xil-se/xildebug_hw/schematics.pdf

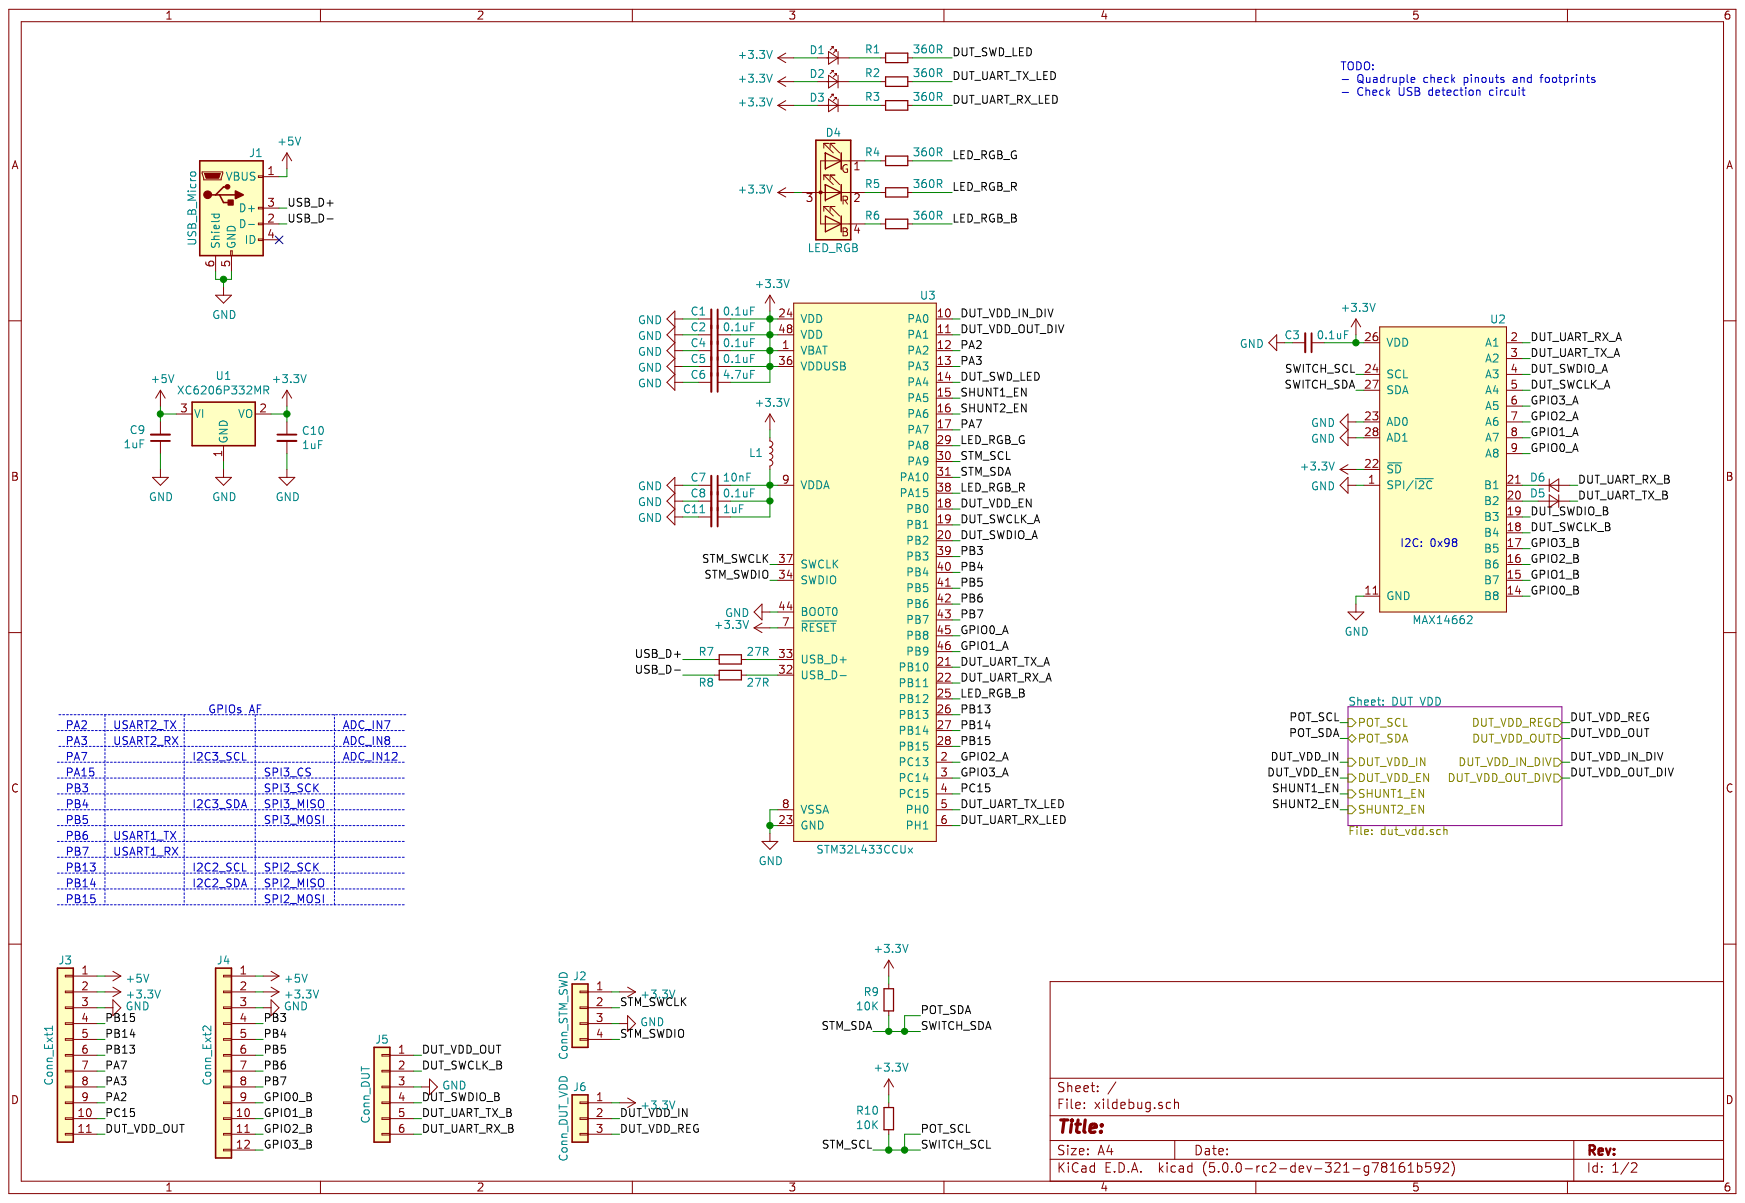
[picture p1: page 1]

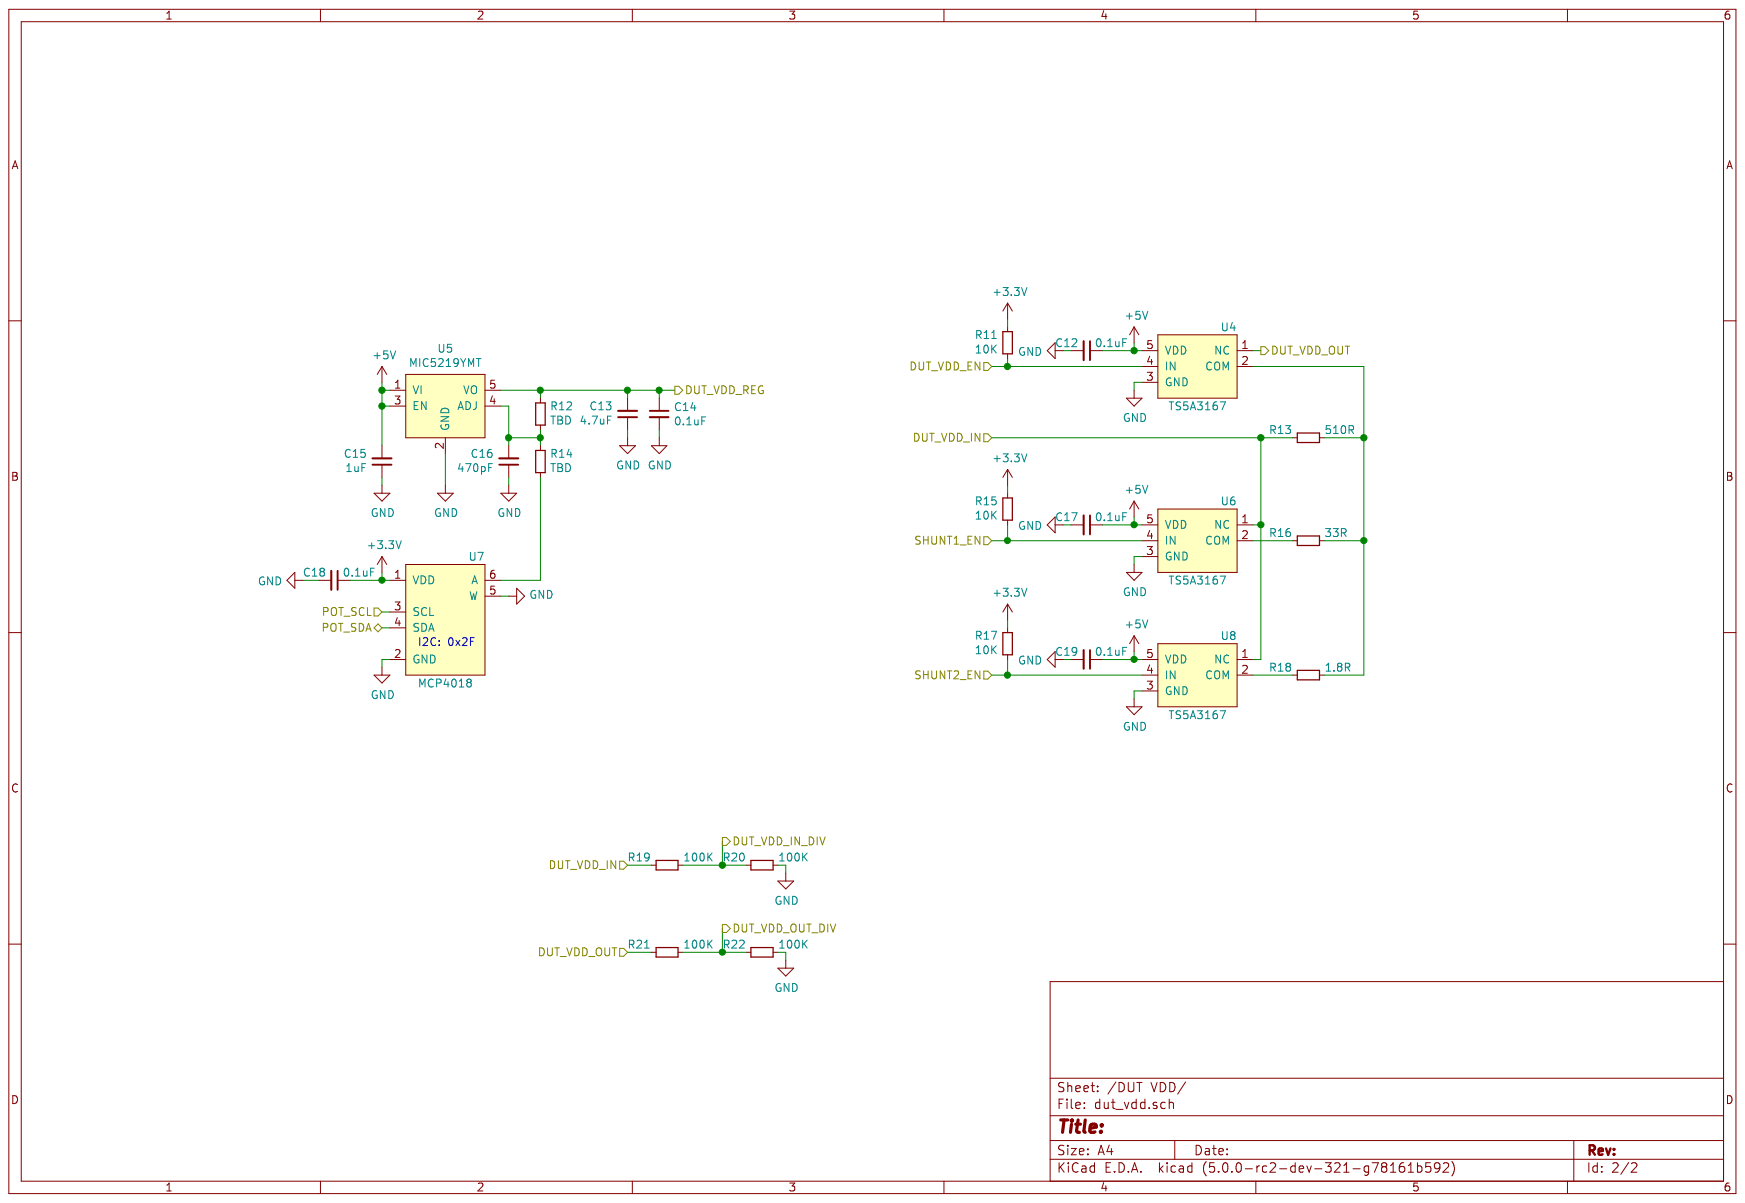
[picture p2: page 2]
