xil-se/xildebug_hw/xildebug.kicad_pcb

## KiCad design xildebug.kicad_pcb (2018-04-21)

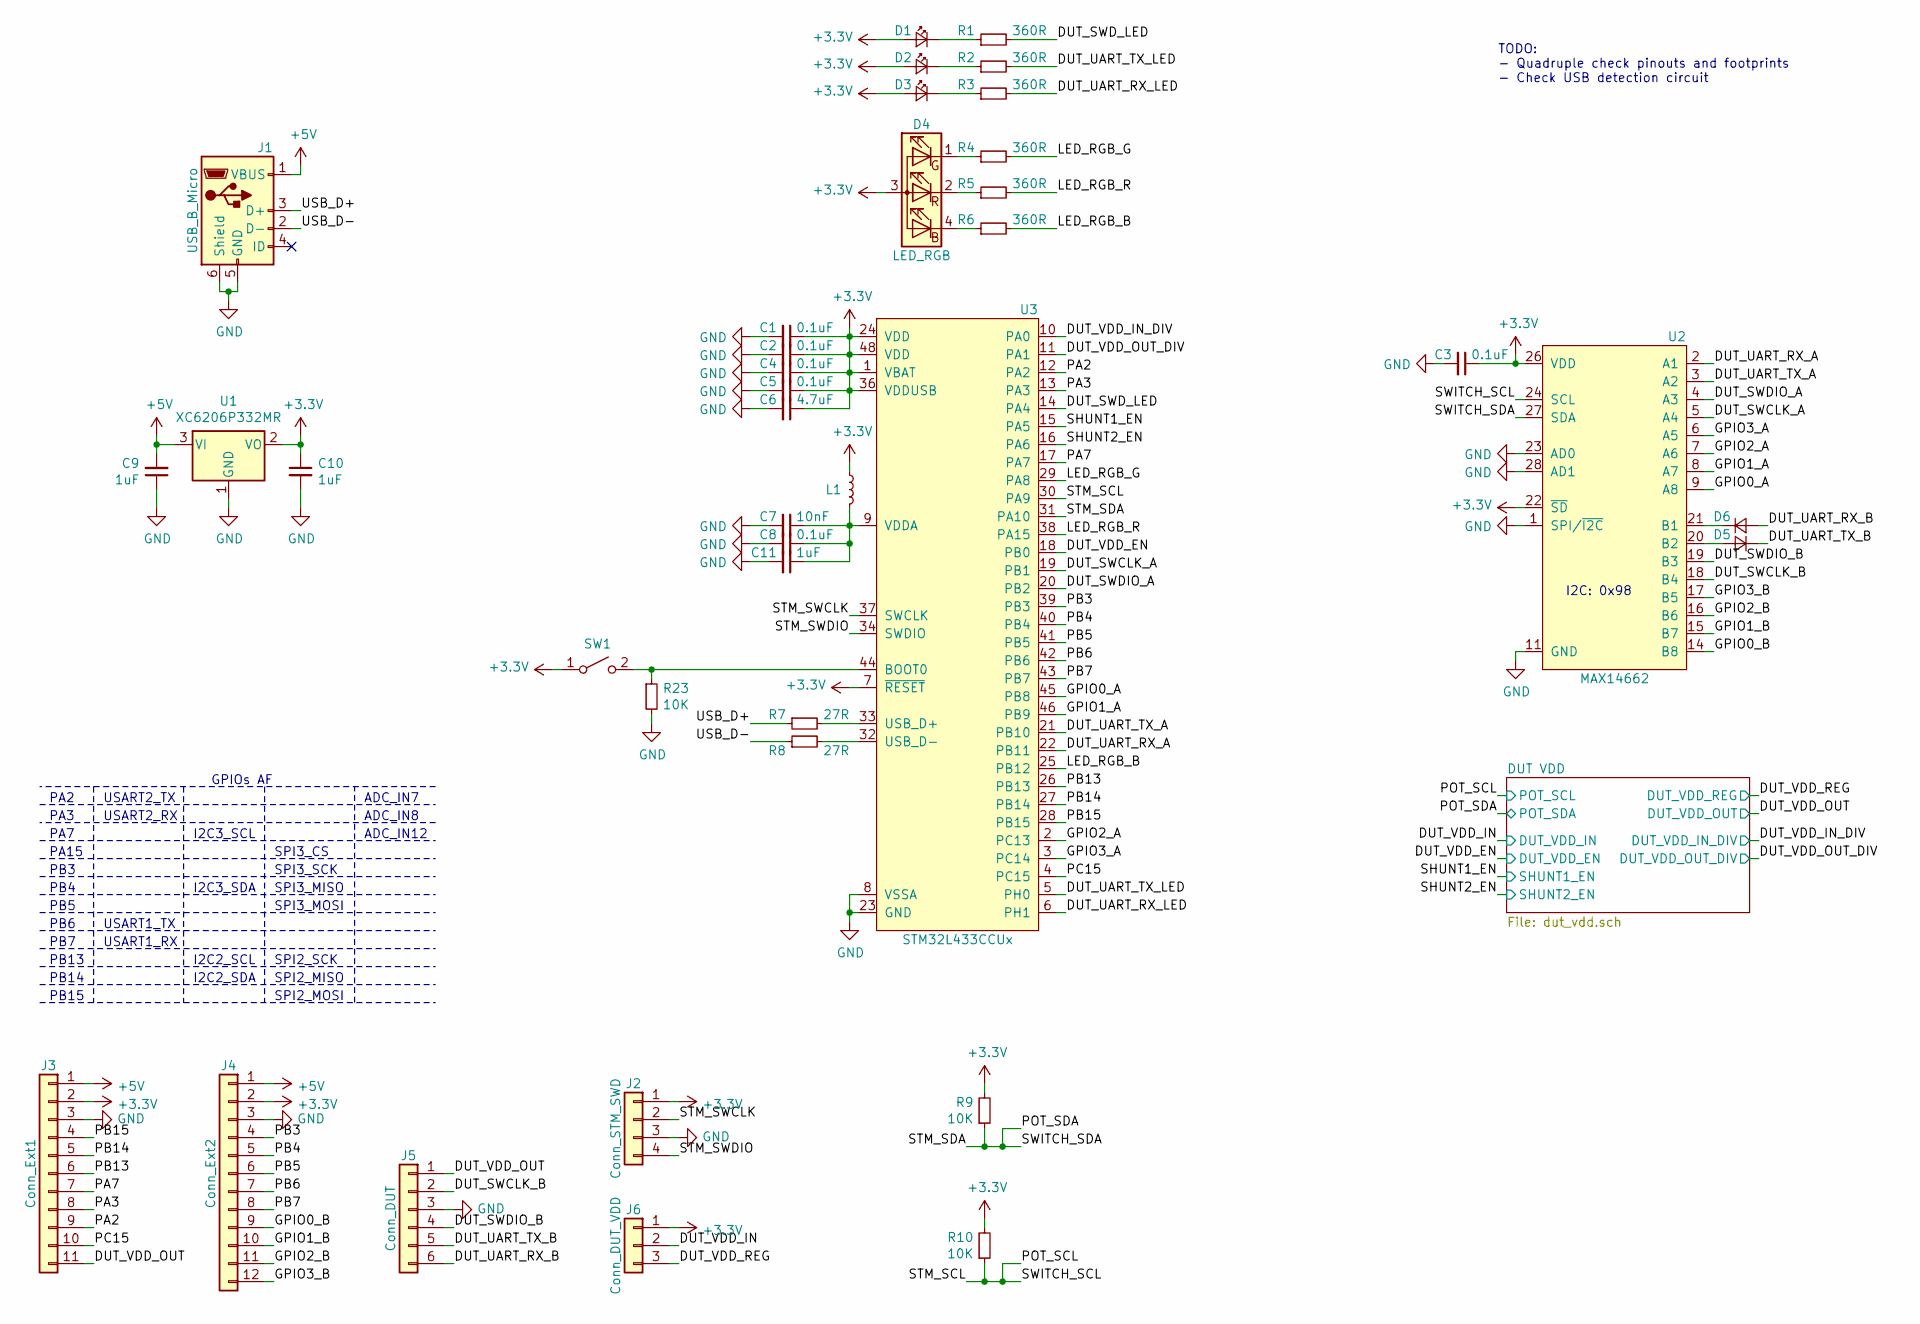
[picture p3: schematic xildebug.sch]

Parts:
C1, C2, C3, C4, C5, C8: 0.1uF; C_0603_1608Metric
C6: 4.7uF; C_0603_1608Metric
C7: 10nF; C_0603_1608Metric
C9, C10, C11: 1uF; C_0603_1608Metric
D1, D2, D3: DUT_UART_TX_LED; LED_0603_1608Metric
D4: LED_RGB; LED_RGB_0606_1616Metric
D5: D_TX; D_SOD-323_HandSoldering
D6: D_RX; D_SOD-323_HandSoldering
J1: USB_B_Micro; USB_Micro-B_Molex-105017-0001
J2: Conn_STM_SWD; PinHeader_1x04_P2.54mm_Vertical
J3: Conn_Ext1; PinHeader_1x11_P2.54mm_Vertical
J4: Conn_Ext2; PinHeader_1x12_P2.54mm_Vertical
J5: Conn_DUT; PinHeader_1x06_P2.54mm_Vertical
J6: Conn_DUT_VDD; PinHeader_1x03_P2.54mm_Horizontal
L1: FB; L_0603_1608Metric
R1, R2, R3, R4, R5, R6: 360R; R_0603_1608Metric
R7, R8: 27R; R_0603_1608Metric
R9, R10, R23: 10K; R_0603_1608Metric
SW1: BOOT0; SW_SPST_B3U-1000P
U1: XC6206P332MR; SOT-23
U2: MAX14662; QFN-28-1EP_4x4mm_P0.4mm_EP2.4x2.4mm
U3: STM32L433CCUx; UFQFPN-48-1EP_7x7mm_P0.5mm_EP5.15x5.15mm

Connections:
+3V3: C1.1, C2.1, C3.1, C4.1, C5.1, C6.1, C10.1, D1.2 (A), D2.2 (A), D3.2 (A), D4.3 (A), J2.1, J3.2, J4.2, J6.1, L1.2, R9.2, R10.2, SW1.1 (A), U1.2 (VO), U2.22 (~SD~), U2.26 (VDD), U3.1 (VBAT), U3.7 (~RESET~), U3.24 (VDD), U3.36 (VDDUSB), U3.48 (VDD); also elsewhere on the board
+5V: C9.2, J1.1 (VBUS), J3.1, J4.1, U1.3 (VI); also elsewhere on the board
/DUT_SWCLK_A: U2.5 (A4), U3.19 (PB1)
/DUT_SWCLK_B: J5.2, U2.18 (B4)
/DUT_SWDIO_A: U2.4 (A3), U3.20 (PB2)
/DUT_SWDIO_B: J5.4, U2.19 (B3)
/DUT_SWD_LED: R1.2, U3.14 (PA4)
/DUT_UART_RX_A: U2.2 (A1), U3.22 (PB11)
/DUT_UART_RX_B: D6.2 (A), J5.6
/DUT_UART_RX_LED: R3.2, U3.6 (PH1)
/DUT_UART_TX_A: U2.3 (A2), U3.21 (PB10)
/DUT_UART_TX_B: D5.1 (K), J5.5
/DUT_UART_TX_LED: R2.2, U3.5 (PH0)
/DUT_VDD_EN: U3.18 (PB0); also elsewhere on the board
/DUT_VDD_IN: J6.2; also elsewhere on the board
/DUT_VDD_IN_DIV: U3.10 (PA0); also elsewhere on the board
/DUT_VDD_OUT: J3.11, J5.1; also elsewhere on the board
/DUT_VDD_OUT_DIV: U3.11 (PA1); also elsewhere on the board
/DUT_VDD_REG: J6.3; also elsewhere on the board
/GPIO0_A: U2.9 (A8), U3.45 (PB8)
/GPIO0_B: J4.9, U2.14 (B8)
/GPIO1_A: U2.8 (A7), U3.46 (PB9)
/GPIO1_B: J4.10, U2.15 (B7)
/GPIO2_A: U2.7 (A6), U3.2 (PC13)
/GPIO2_B: J4.11, U2.16 (B6)
/GPIO3_A: U2.6 (A5), U3.3 (PC14)
/GPIO3_B: J4.12, U2.17 (B5)
/LED_RGB_B: R6.2, U3.25 (PB12)
/LED_RGB_G: R4.2, U3.29 (PA8)
/LED_RGB_R: R5.2, U3.38 (PA15)
/PA2: J3.9, U3.12 (PA2)
/PA3: J3.8, U3.13 (PA3)
/PA7: J3.7, U3.17 (PA7)
/PB3: J4.4, U3.39 (PB3)
/PB4: J4.5, U3.40 (PB4)
/PB5: J4.6, U3.41 (PB5)
/PB6: J4.7, U3.42 (PB6)
/PB7: J4.8, U3.43 (PB7)
/PB13: J3.6, U3.26 (PB13)
/PB14: J3.5, U3.27 (PB14)
/PB15: J3.4, U3.28 (PB15)
/PC15: J3.10, U3.4 (PC15)
/POT_SCL: R10.1, U2.24 (SCL), U3.30 (PA9); also elsewhere on the board
/POT_SDA: R9.1, U2.27 (SDA), U3.31 (PA10); also elsewhere on the board
/SHUNT1_EN: U3.15 (PA5); also elsewhere on the board
/SHUNT2_EN: U3.16 (PA6); also elsewhere on the board
/STM_SWCLK: J2.2, U3.37 (SWCLK)
/STM_SWDIO: J2.4, U3.34 (SWDIO)
/USB_D+: J1.3 (D+), R7.1
/USB_D-: J1.2 (D-), R8.1
GND: C1.2, C2.2, C3.2, C4.2, C5.2, C6.2, C7.2, C8.2, C9.1, C10.2, C11.2, J1.5 (GND), J1.6 (Shield), J2.3, J3.3, J4.3, J5.3, R23.2, U1.1 (GND), U2.1 (SPI/~I2C~), U2.11 (GND), U2.23 (AD0), U2.25 (GND), U2.28 (AD1), U2.29 (GND), U3.8 (VSSA), U3.23 (GND), U3.35 (GND), U3.47 (GND); also elsewhere on the board
unnamed: C7.1, C8.1, C11.1, L1.1, U3.9 (VDDA)
unnamed: D1.1 (K), R1.1
unnamed: D2.1 (K), R2.1
unnamed: D3.1 (K), R3.1
unnamed: D4.1 (GK), R4.1
unnamed: D4.2 (RK), R5.1
unnamed: D4.4 (BK), R6.1
unnamed: D5.2 (A), U2.20 (B2)
unnamed: D6.1 (K), U2.21 (B1)
unnamed: R7.2, U3.33 (USB_D+)
unnamed: R8.2, U3.32 (USB_D-)
unnamed: R23.1, SW1.2 (B), U3.44 (BOOT0)

Notes on the sheet:
TODO: - Quadruple check pinouts and footprints - Check USB detection circuit
GPIOs AF
PA2
PA3
PA7
PA15
PB3
PB4
PB5
PB7
PB13
PB14
PB15
USART2_TX
USART2_RX
PB6
USART1_TX
USART1_RX
I2C3_SCL
I2C3_SDA
I2C2_SCL
I2C2_SDA
SPI3_CS
SPI3_SCK
SPI3_MISO
SPI3_MOSI
SPI2_SCK
SPI2_MISO
SPI2_MOSI
ADC_IN7
ADC_IN8
ADC_IN12
I2C: 0x98

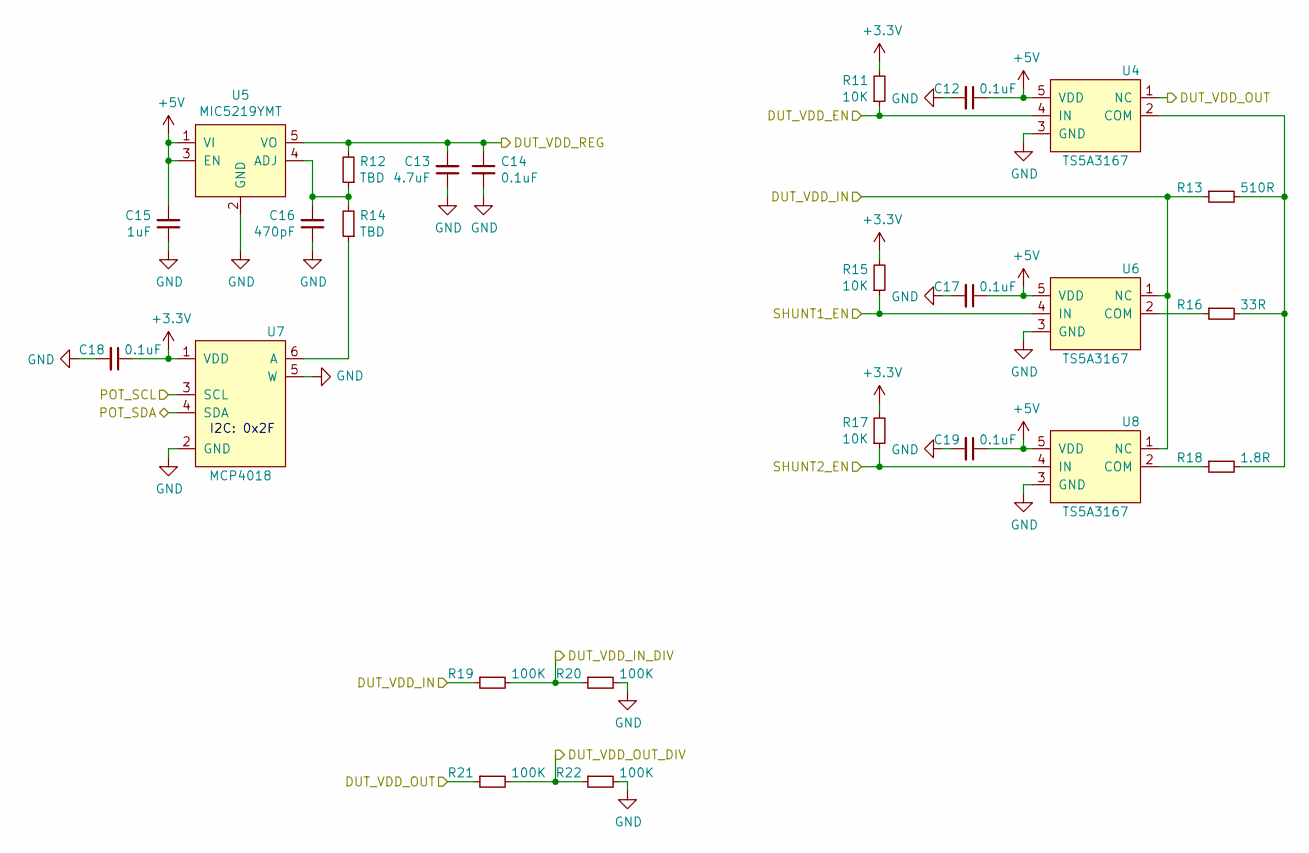
[picture p4: schematic dut_vdd.sch]

Parts:
C12, C14, C17, C18, C19: 0.1uF; C_0603_1608Metric
C13: 4.7uF; C_0603_1608Metric
C15: 1uF; C_0603_1608Metric
C16: 470pF; C_0603_1608Metric
R11, R15, R17: 10K; R_0603_1608Metric
R12, R14: TBD; R_0603_1608Metric
R13: 510R; R_0603_1608Metric
R16: 33R; R_0603_1608Metric
R18: 1.8R; R_0603_1608Metric
R19, R20, R21, R22: 100K; R_0603_1608Metric
U4, U6, U8: TS5A3167; SOT-23-5
U5: MIC5219YMT; SOT-23-5
U7: MCP4018; SOT-363_SC-70-6

Connections:
+3V3: C18.1, R11.2, R15.2, R17.2, U7.1 (VDD); also elsewhere on the board
+5V: C12.1, C15.2, C17.1, C19.1, U4.5 (VDD), U5.1 (VI), U5.3 (EN), U6.5 (VDD), U8.5 (VDD); also elsewhere on the board
/DUT_VDD_EN: R11.1, U4.4 (IN); also elsewhere on the board
/DUT_VDD_IN: R13.1, R19.1, U6.1 (NC), U8.1 (NC); also elsewhere on the board
/DUT_VDD_IN_DIV: R19.2, R20.1; also elsewhere on the board
/DUT_VDD_OUT: R21.1, U4.1 (NC); also elsewhere on the board
/DUT_VDD_OUT_DIV: R21.2, R22.1; also elsewhere on the board
/DUT_VDD_REG: C13.2, C14.1, R12.2, U5.5 (VO); also elsewhere on the board
/POT_SCL: U7.3 (SCL); also elsewhere on the board
/POT_SDA: U7.4 (SDA); also elsewhere on the board
/SHUNT1_EN: R15.1, U6.4 (IN); also elsewhere on the board
/SHUNT2_EN: R17.1, U8.4 (IN); also elsewhere on the board
GND: C12.2, C13.1, C14.2, C15.1, C16.1, C17.2, C18.2, C19.2, R20.2, R22.2, U4.3 (GND), U5.2 (GND), U6.3 (GND), U7.2 (GND), U7.5 (W), U8.3 (GND); also elsewhere on the board
unnamed: C16.2, R12.1, R14.2, U5.4 (ADJ)
unnamed: R13.2, R16.2, R18.2, U4.2 (COM)
unnamed: R14.1, U7.6 (A)
unnamed: R16.1, U6.2 (COM)
unnamed: R18.1, U8.2 (COM)

Notes on the sheet:
I2C: 0x2F

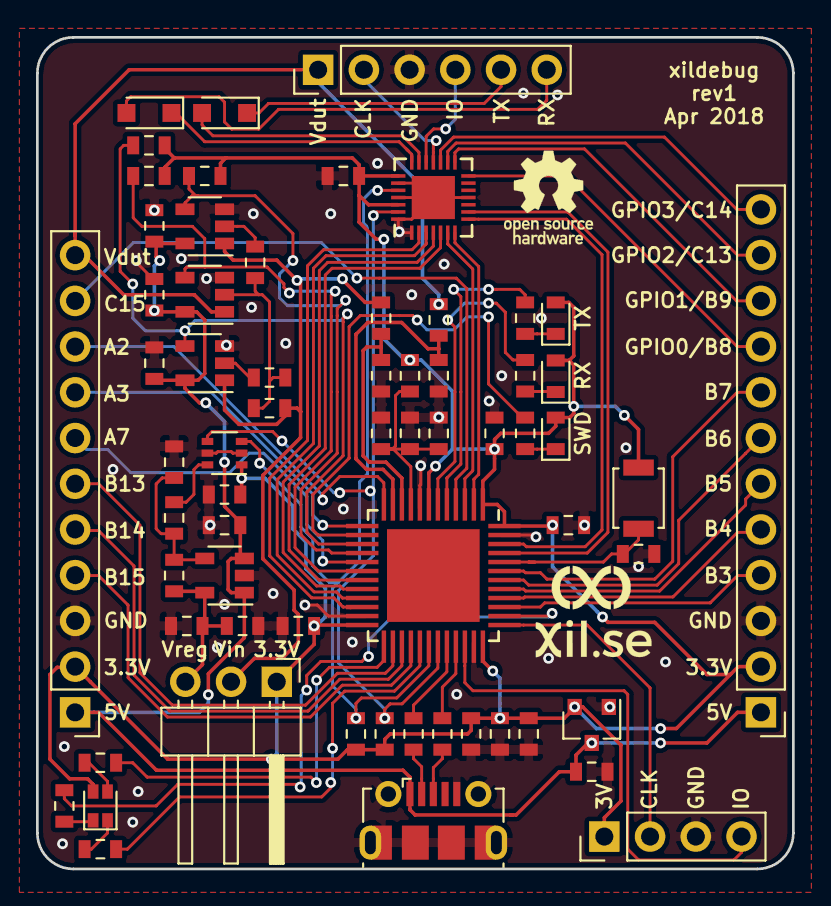
[picture p5: board xildebug.kicad_pcb from above]

Board: 2 copper layers, 42.0 x 46.2 mm, 64 parts (0 on the bottom side), 68 nets.
