xil-se/xildebug_hw/(threads)

Thread 1 (2018-04-21):

Ideas for future revisions

kbeckmann, 2018-04-21:
Let's keep this issue as a discussion board for future features. I'll start.

### Level shifter
Let's add a level shifter, e.g. [FXMA108](http://www.onsemi.com/PowerSolutions/product.do?id=FXMA108) that was used in https://github.com/whitequark/Glasgow.

We could simply hook it up to the DUT_VDD_IN pin, so we ensure that the DUT and the voltage we shift to are the same. Might be problematic with the actual current consumptions though. I'm just a bit worried that it might affect the current measurement.

kbeckmann, 2018-04-22:
## Cap draining mosfet
Something to help kill off the left over capacitance in the DUT when cutting off power to it.

Thread 3 (2018-04-22):

Footprint for RGB led flips common and green pin

kbeckmann, 2018-04-22:
There is no other explanation as far as I can tell.. Or you mounted the wrong LED :grin:

Since the common pin is +3.3V, gpios should be low in order to turn on a color.

Green pin must be high in order to get red or blue to light up. This makes it seem to me like the green pin is actually the common. Green color can't be turned on at all.

kbeckmann, 2018-04-23:
LED seems to have been flipped on my board. But that doesn't explain why red and blue have the correct colors. If the LED was flipped, wouldn't the colors also be flipped? Confused.
