xil-se/xildebug_hw/(commit log)

2018-03-29 Initial import, WIP
    [xildebug.kicad_pcb, xildebug.sch]
2018-03-29 Update footprints to nightly
    [xildebug.sch]
2018-03-30 More work on the schematic
    Replaced the STM chip with one that has more GPIO
    Added decoupling to STM
    Moved VDD circuitry to separate sheet
    Added RGB LED
    [dut_vdd.sch, xildebug.sch]
2018-03-30 Update sub-schematic pin directions
    [dut_vdd.sch, xildebug.sch]
2018-03-30 Changed the USB data pin names to match the USB connector convention
    [xildebug.sch]
2018-04-02 Add ferrite bead on the VDDA of the STM
    [xildebug.sch]
2018-04-02 Add footprint for the STM that works for QFN and QFP
    [xildebug.sch]
2018-04-04 Route the PCB
    [xildebug.sch]
2018-04-05 Add DUT silk
    [xildebug.kicad_pcb]
2018-04-08 Add button on BOOT0
    [xildebug.kicad_pcb, xildebug.sch]
2018-04-21 Last touch-up for the production, add gerber files
    [xildebug-B.Cu.gbl, xildebug-B.Mask.gbs, xildebug-B.Paste.gbp, xildebug-B.SilkS.gbo, xildebug-Edge.Cuts.gm1, xildebug-F.Cu.gtl, xildebug-F.Mask.gts, xildebug-F.Paste.gtp]
